PrBelamine/desk-watch/docs/photos/Cover.png

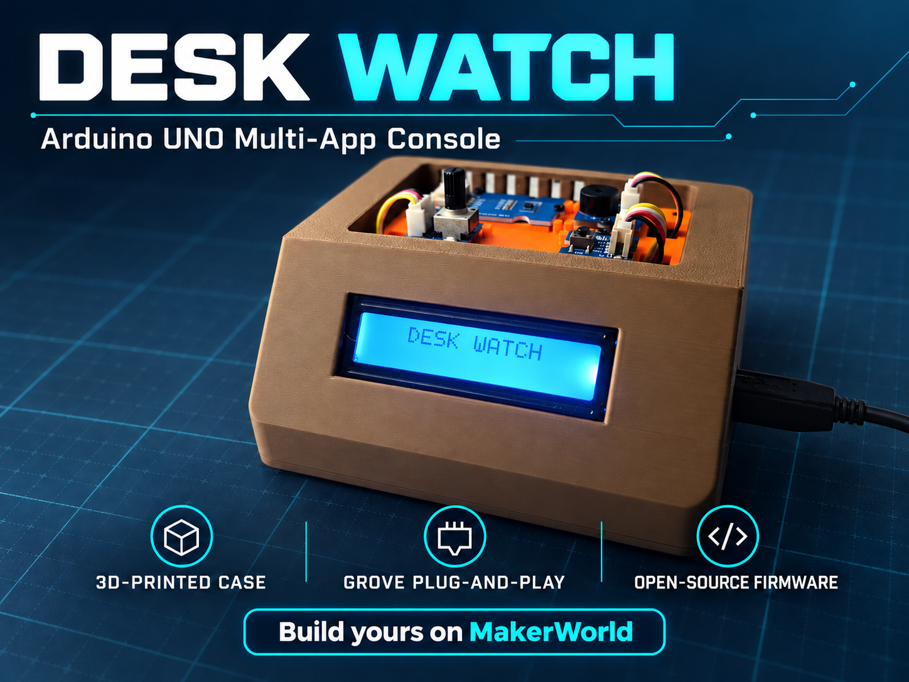
docs/photos/Cover.png
