PrBelamine/desk-watch/docs/photos/desk_watch_0_cover.jpg

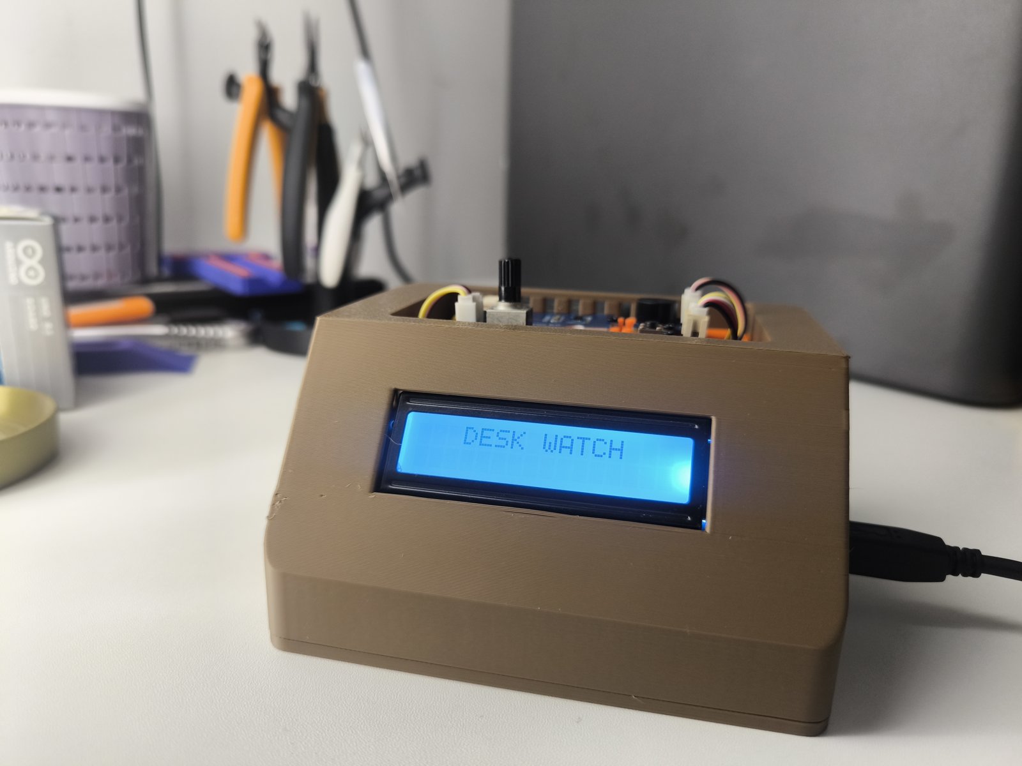
docs/photos/desk_watch_0_cover.jpg
