PrBelamine/desk-watch/docs/photos/main_cover.png

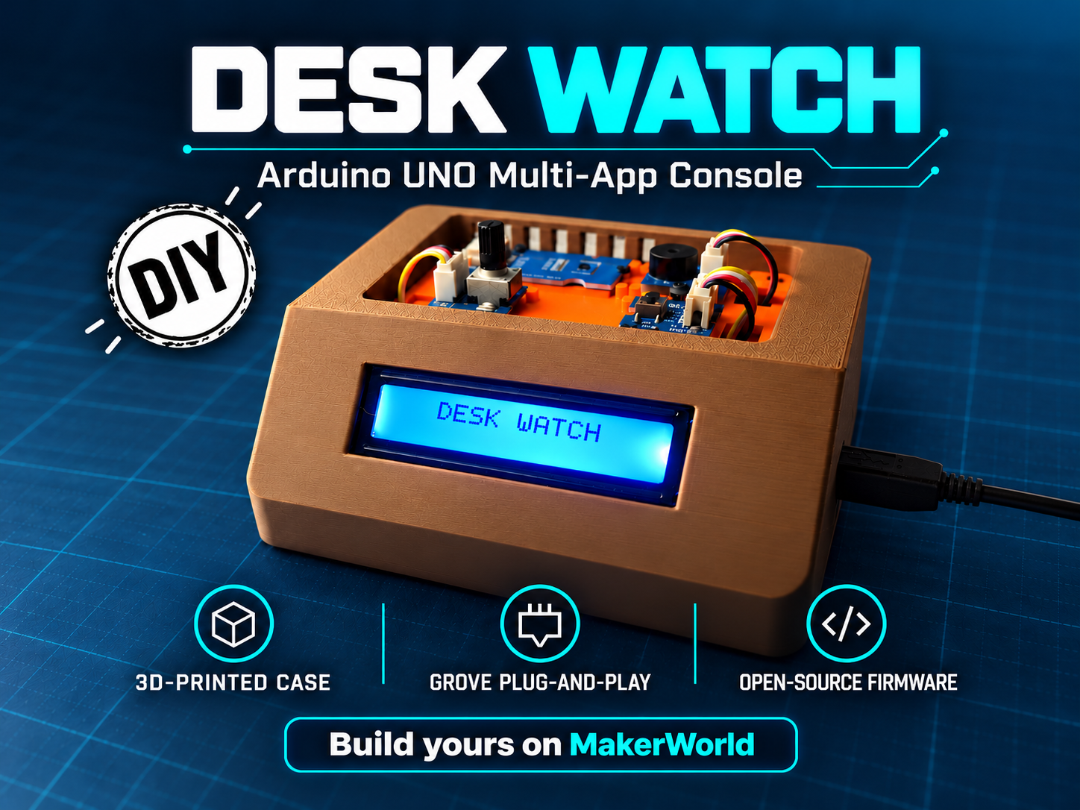
docs/photos/main_cover.png
