PrBelamine/desk-watch/(commit log)

2026-10-20 Mention SHT31/SHT40 modules and current project links
2026-10-20 README_FR: la langue est fixée par la version
2026-10-20 docs: user and screw guides, EN and FR
2026-10-27 docs et firmware: nouveaux guides utilisateur MELODY et TEACHER (FR, EN), ecran Examen en anglais, commentaires d'en-tete corriges (mise a jour du 28 octobre 2026)
    [Desk_Watch_1_MELODY_Edition_EN.ino, Desk_Watch_1_MELODY_Edition_FR.ino, Desk_Watch_1_TEACHER_Edition_EN.ino, Desk_Watch_1_TEACHER_Edition_FR.ino]
2026-10-28 firmware et guides: volume a cinq niveaux (Min a Max), buzzer plus fort au maximum (mise a jour du 28 octobre 2026)
    [Desk_Watch_1_MELODY_Edition_EN.ino, Desk_Watch_1_MELODY_Edition_FR.ino, Desk_Watch_1_TEACHER_Edition_EN.ino, Desk_Watch_1_TEACHER_Edition_FR.ino]
